inventor02/low-cost-mmwave/pcbs/Dual HF AWR2243 Radar Cascade Board/Photos.pdf

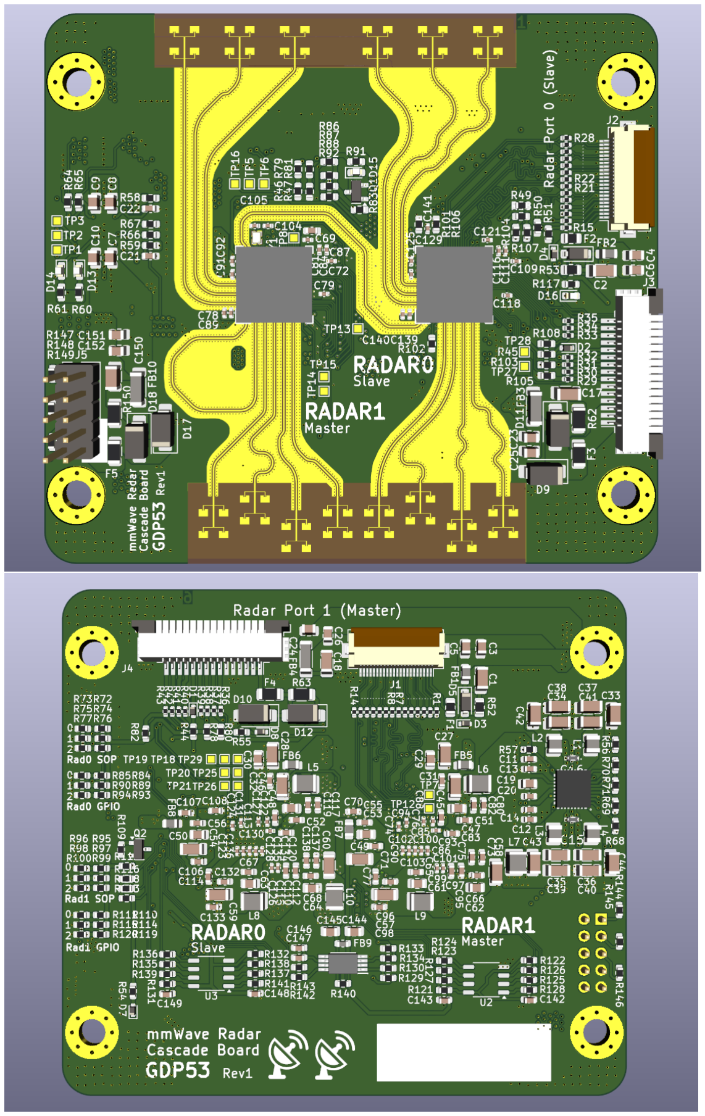
[picture p8: figure]

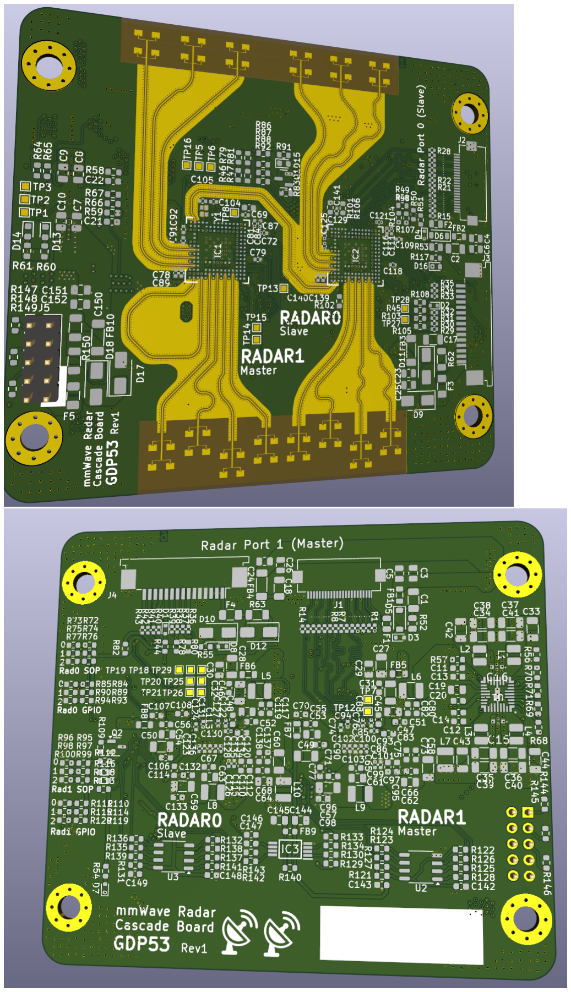
[picture p9: figure]
