inventor02/low-cost-mmwave/code/web-interface/images/range doppler map.png

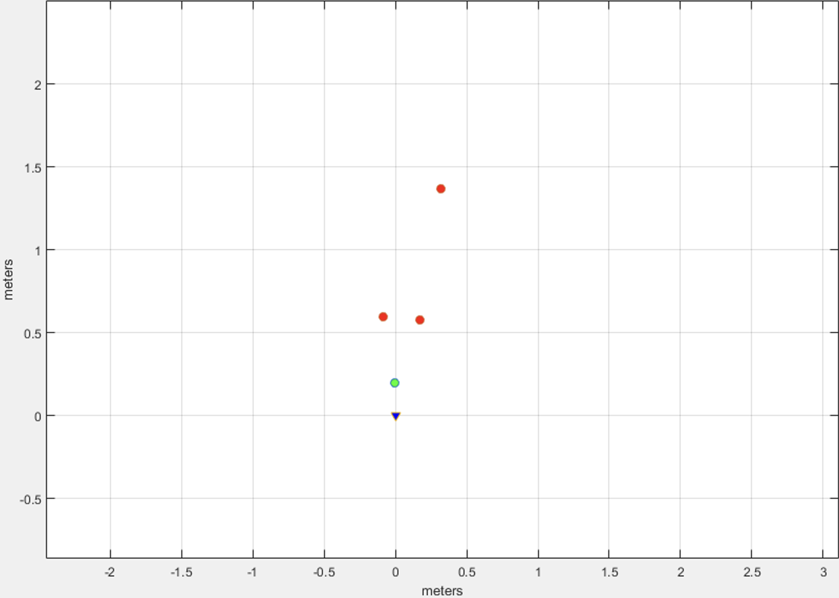
code/web-interface/images/range doppler map.png
