inventor02/low-cost-mmwave/code/web-interface/images/range range map.png

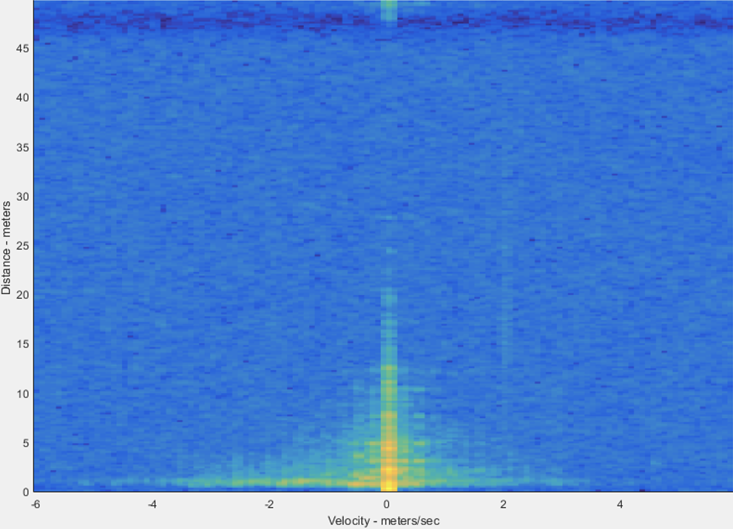
code/web-interface/images/range range map.png
