inventor02/low-cost-mmwave/pcbs/CM4RadarBoard/Board Images/Antenna.jpg

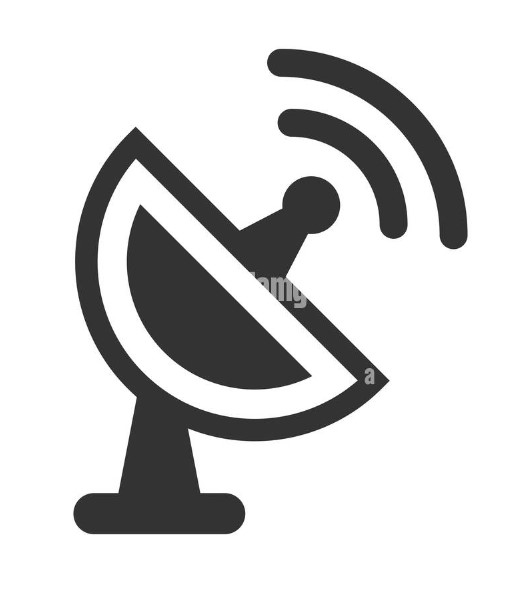
pcbs/CM4RadarBoard/Board Images/Antenna.jpg
