inventor02/low-cost-mmwave/cad/TopPlate.dxf

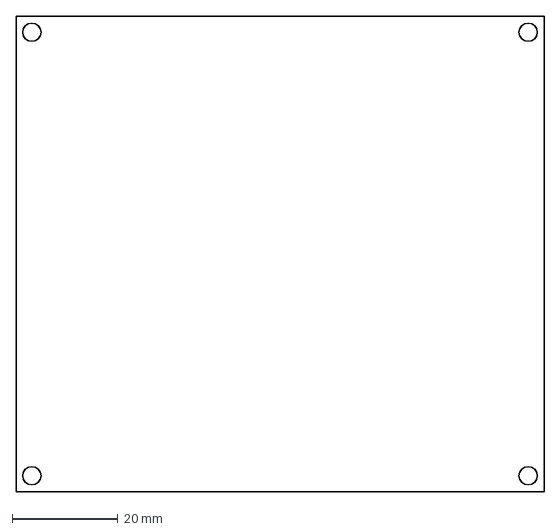
[picture p13: CAD file, 2025-01-19]
cad/TopPlate.dxf
100.0 x 90.0 mm
