inventor02/low-cost-mmwave/pcbs/AdapterBoard/3DModels/QTH-030-01-X-D-A.step

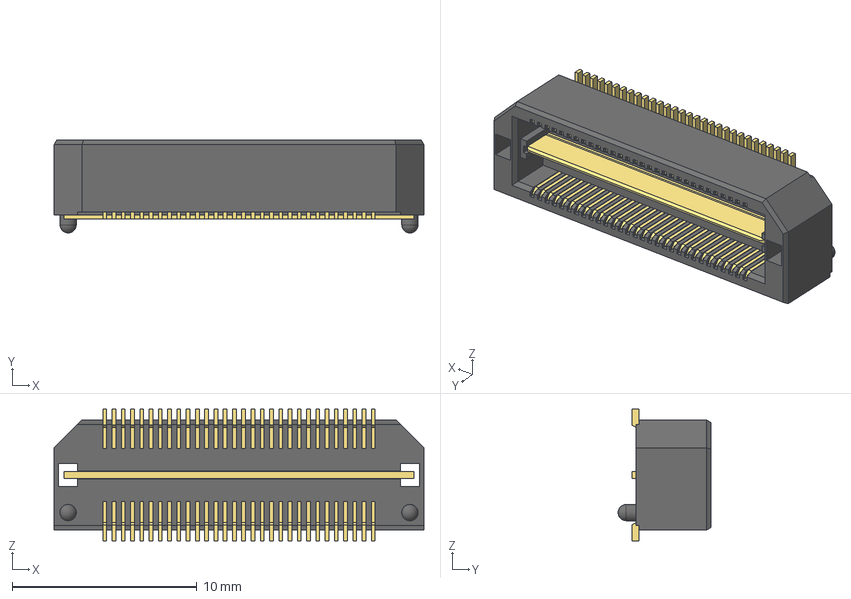
[picture p14: CAD file, 2025-01-20]
pcbs/AdapterBoard/3DModels/QTH-030-01-X-D-A.step
20.0 x 5.03 x 7.11 mm
TQTH-030-01-H-D-A_terminal
T-1S39-01(-030-01-D-H)_pin
T-1S39-01(-030-01-D)_pin2
T-1G1-01_imp
