inventor02/low-cost-mmwave/cad/GDP53_HousingDesignV2.stl

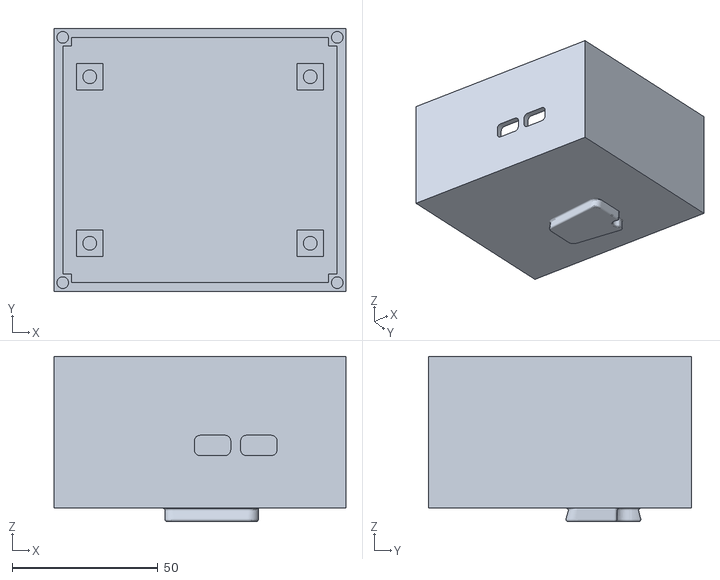
[picture p15: CAD file, 2025-01-19]
cad/GDP53_HousingDesignV2.stl
100.0 x 90.0 x 56.6
