inventor02/low-cost-mmwave/cad/MountPlateCasingGDP53 v1.step

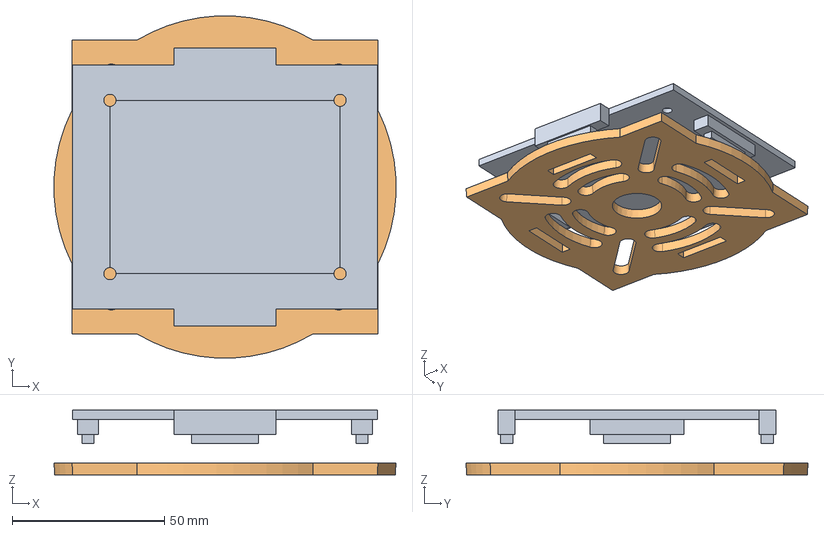
[picture p16: CAD file, 2025-01-19]
cad/MountPlateCasingGDP53 v1.step
112.3 x 112.3 x 21.2 mm
