inventor02/low-cost-mmwave/(list of files, cad)

Other CAD files:
cad/CM4RadarBoardHousingV2 v1.f3d
cad/PowManageBox v1.f3d
cad/PowManageBox v2.2.f3d
cad/PowManageBox v2.f3d
