inventor02/low-cost-mmwave/cad/Housing_Design_Sketch.pdf

# BatteryLipo 3

,

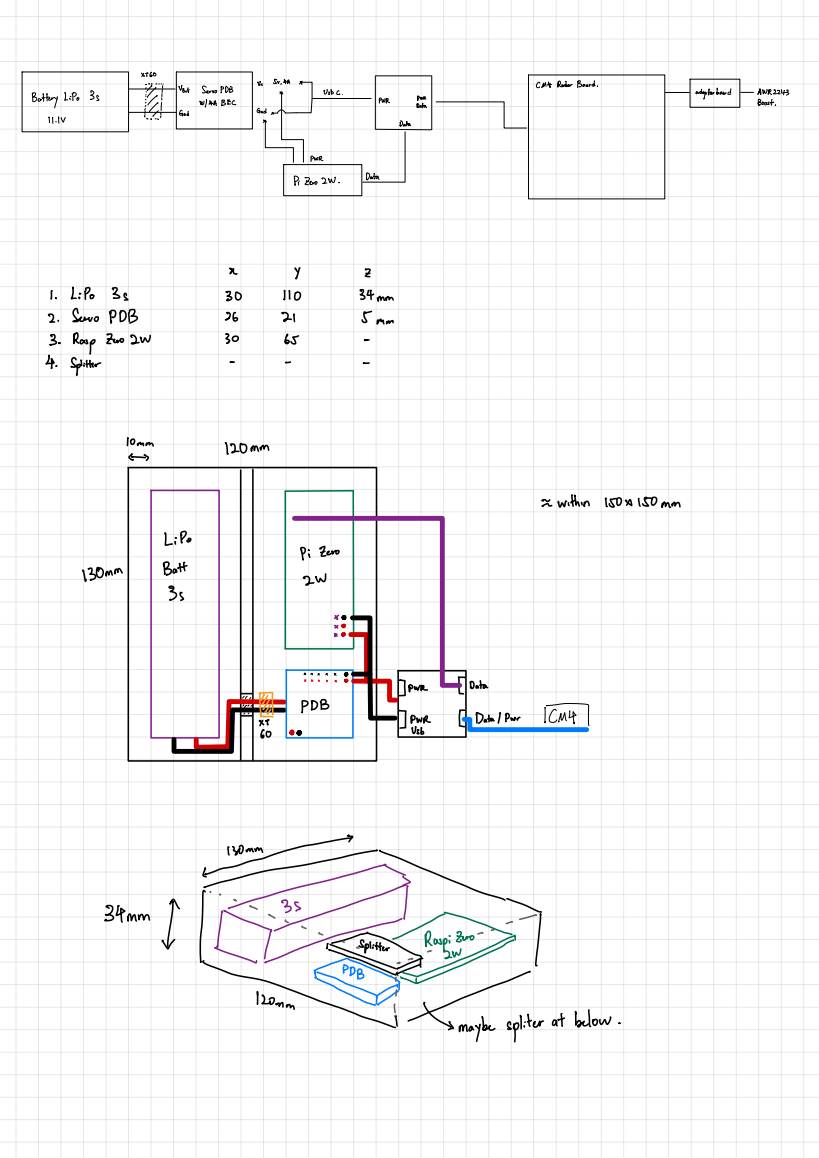
[picture p23: page 1]
UsbC .; adaptarboard; AWR2243; SeoDRB; PWR; Radar Board .; Boost.; Gad; Datta; Pi Zero 2W .; Data; LiPo; Surro; PDB; Rasp; Zero; Splitter; within; Pi Zero; Batt; Jour; [Data; JOUR; [Datalpur; Raspi morZero

2. | 30 Adaptor | board

## Adaptor

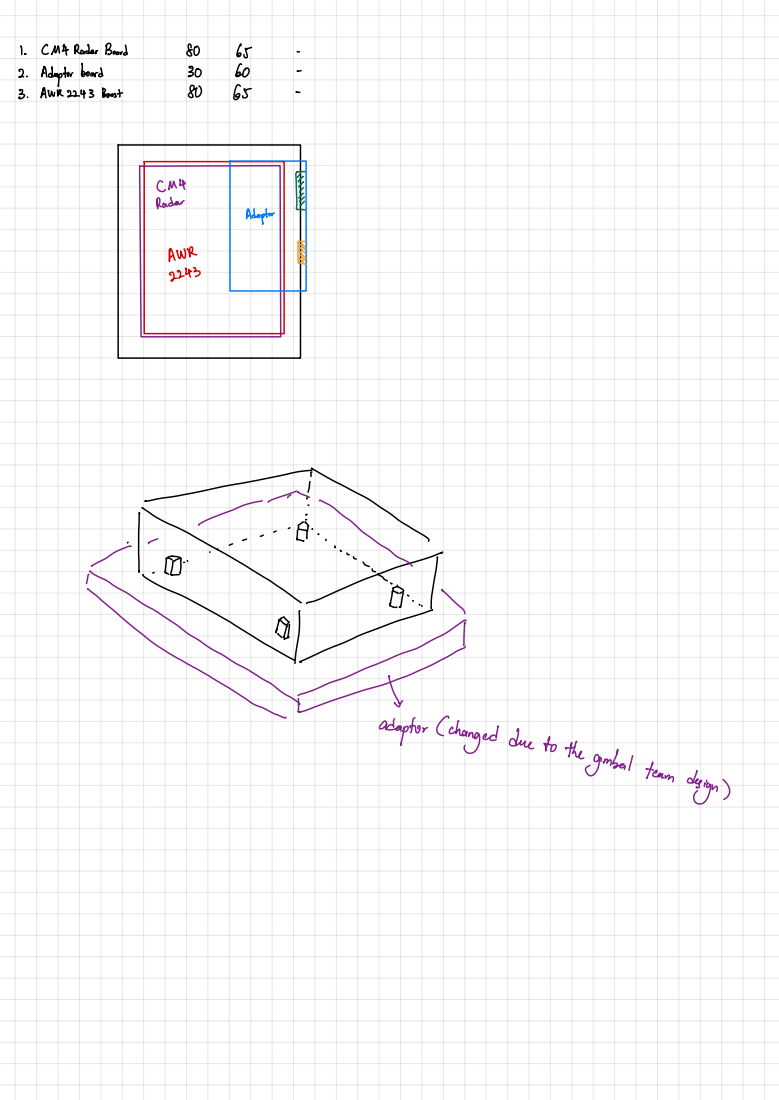
[picture p24: page 2]
CM4 Radar; Board; AWR 2243; Boost; Radar; AWR; adaptor (changed due to thegimbal; team; design
