inventor02/low-cost-mmwave/cad/Housing_Design_Sketch_V2.pdf

# BatteryLipo 3

,

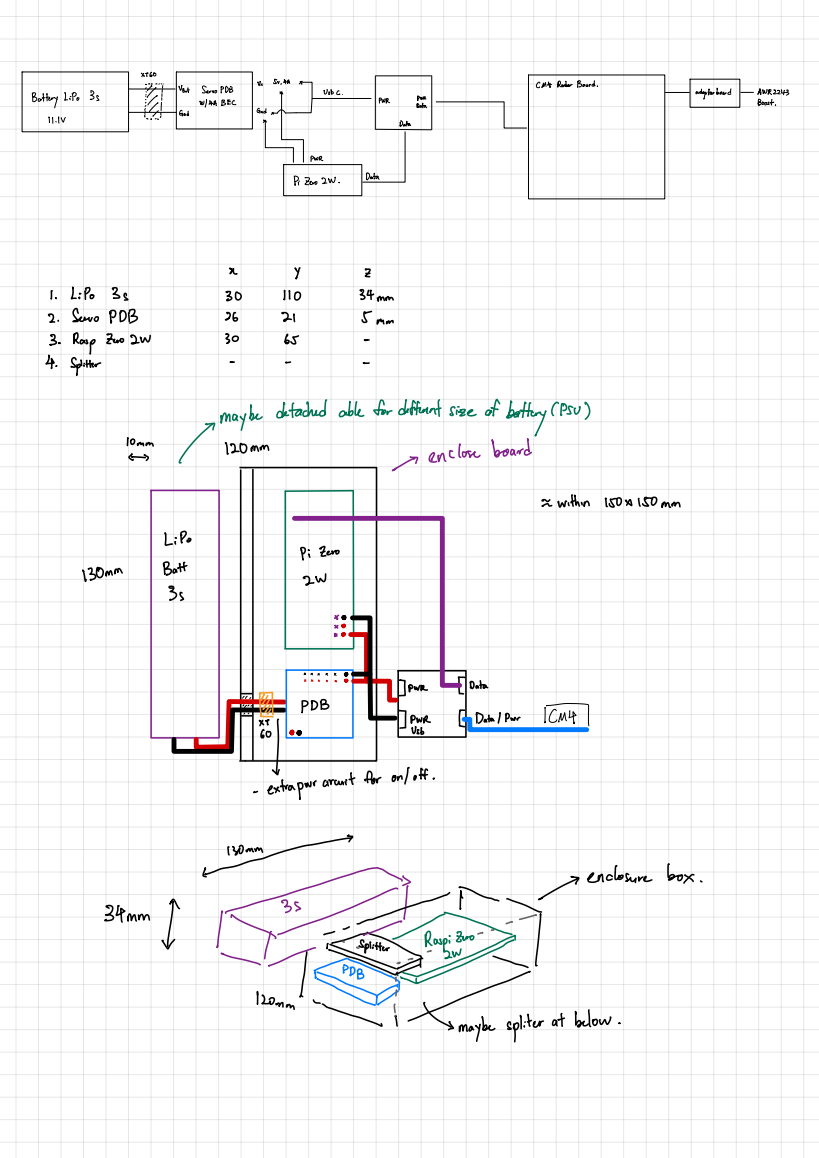
[picture p25: page 1]
SeoDRB; UsbC .; Radar Board .; adaptarboard; AWR2243; PWR; Boost.; Gad; Datta; Pi Zero 2W .; Data; LiPo; Surro; PDB; Rasp; Zero; Splitter; maybe; detached; able for different; size of battery ⁽PSV); comm; enclose; board; piz; Jour; [Data; within; [Datalpur; - TenT

extrapor arcuit for on/off.
Num

Adaptor | board | 30

su

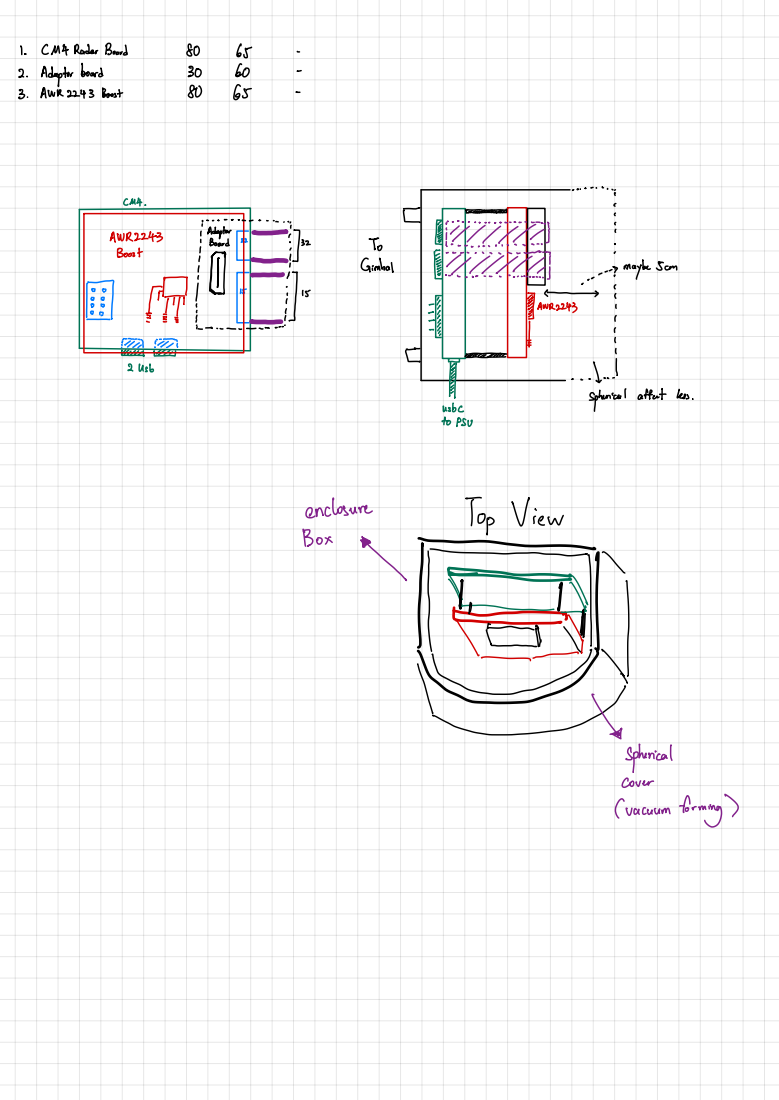
[picture p26: page 2]
CM4 Radar; Board; AWR 2243; Boost; ----- maybe Som; FFantas #11; spherical; affect less.; enclosure; cover; (vacuum; forming⁽

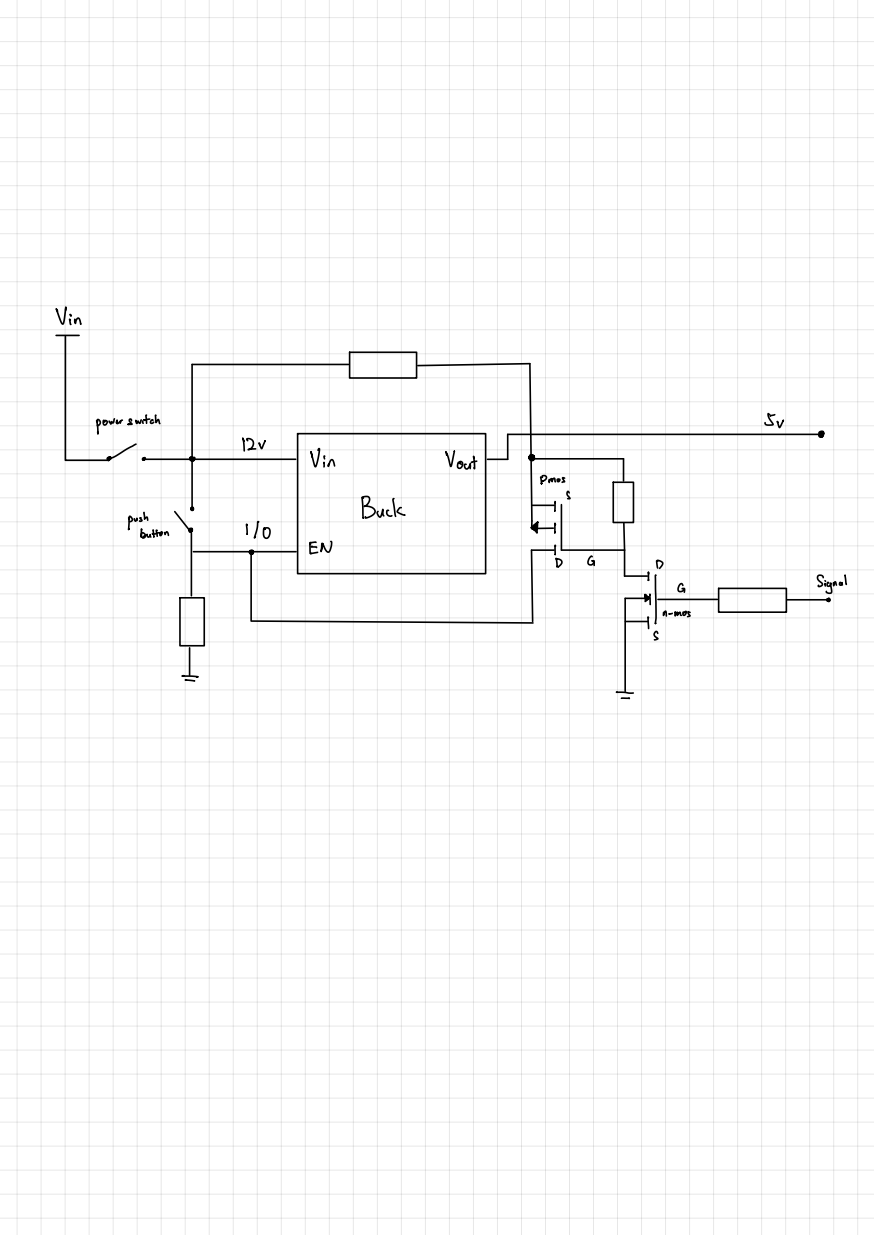
[picture p27: page 3]
Vin; power; switch; Vout; Pmos; Buck; button; push; · Signal n-mos
