inventor02/low-cost-mmwave/pcbs/AdapterBoard/CM4-AWRInterfaceBoard.kicad_pcb

## KiCad design pcbs/AdapterBoard/CM4-AWRInterfaceBoard.kicad_pcb (2025-01-20)

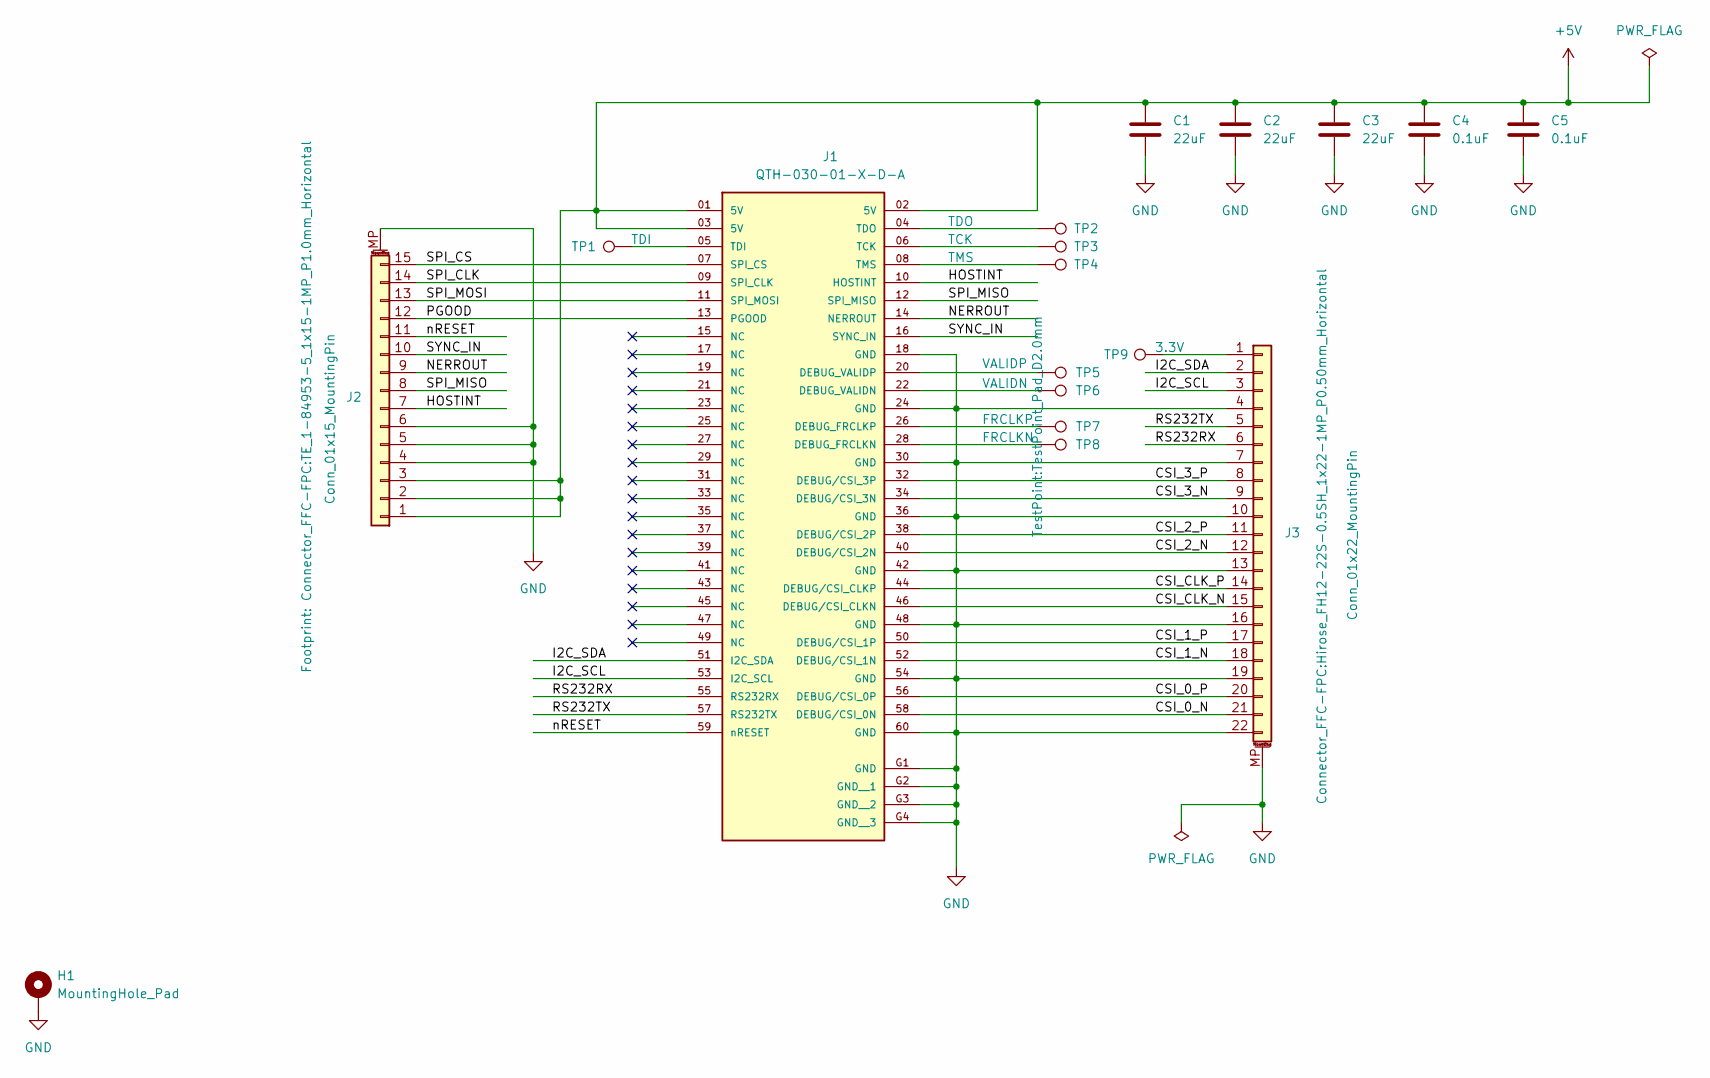
[picture p40: schematic Samtech QTH-030-01-L-D-A.kicad_sch]

Parts:
C1, C2, C3: 22uF; C_1206_3216Metric
C4, C5: 0.1uF; C_0805_2012Metric
H1: MountingHole_Pad; MountingHole_4.3mm_M4_Pad_Via
J1: QTH-030-01-X-D-A; SAMTEC-QTH-030-01-X-D-A; PARTREV L
J2: Conn_01x15_MountingPin; TE_1-84953-5_1x15-1MP_P1.0mm_Horizontal
J3: Conn_01x22_MountingPin; Hirose_FH12-22S-0.5SH_1x22-1MP_P0.50mm_Horizontal
TP1: TDI; TestPoint_Pad_D2.0mm
TP2: TDO; TestPoint_Pad_D2.0mm
TP3: TCK; TestPoint_Pad_D2.0mm
TP4: TMS; TestPoint_Pad_D2.0mm
TP5: VALIDP; TestPoint_Pad_D2.0mm
TP6: VALIDN; TestPoint_Pad_D2.0mm
TP7: FRCLKP; TestPoint_Pad_D2.0mm
TP8: FRCLKN; TestPoint_Pad_D2.0mm
TP9: 3.3V; TestPoint_Pad_D2.0mm

Connections:
+5V: C1.1, C2.1, C3.1, C4.1, C5.1, J1.01 (5V), J1.02 (5V), J1.03 (5V), J2.1, J2.2, J2.3
/Samtech QTH-030-01-L-D-A/CSI_0_N: J1.58 (DEBUG/CSI_0N), J3.21
/Samtech QTH-030-01-L-D-A/CSI_0_P: J1.56 (DEBUG/CSI_0P), J3.20
/Samtech QTH-030-01-L-D-A/CSI_1_N: J1.52 (DEBUG/CSI_1N), J3.18
/Samtech QTH-030-01-L-D-A/CSI_1_P: J1.50 (DEBUG/CSI_1P), J3.17
/Samtech QTH-030-01-L-D-A/CSI_2_N: J1.40 (DEBUG/CSI_2N), J3.12
/Samtech QTH-030-01-L-D-A/CSI_2_P: J1.38 (DEBUG/CSI_2P), J3.11
/Samtech QTH-030-01-L-D-A/CSI_3_N: J1.34 (DEBUG/CSI_3N), J3.9
/Samtech QTH-030-01-L-D-A/CSI_3_P: J1.32 (DEBUG/CSI_3P), J3.8
/Samtech QTH-030-01-L-D-A/CSI_CLK_N: J1.46 (DEBUG/CSI_CLKN), J3.15
/Samtech QTH-030-01-L-D-A/CSI_CLK_P: J1.44 (DEBUG/CSI_CLKP), J3.14
/Samtech QTH-030-01-L-D-A/HOSTINT: J1.10 (HOSTINT), J2.7
/Samtech QTH-030-01-L-D-A/I2C_SCL: J1.53 (I2C_SCL), J3.3
/Samtech QTH-030-01-L-D-A/I2C_SDA: J1.51 (I2C_SDA), J3.2
/Samtech QTH-030-01-L-D-A/NERROUT: J1.14 (NERROUT), J2.9
/Samtech QTH-030-01-L-D-A/PGOOD: J1.13 (PGOOD), J2.12
/Samtech QTH-030-01-L-D-A/RS232RX: J1.55 (RS232RX), J3.6
/Samtech QTH-030-01-L-D-A/RS232TX: J1.57 (RS232TX), J3.5
/Samtech QTH-030-01-L-D-A/SPI_CLK: J1.09 (SPI_CLK), J2.14
/Samtech QTH-030-01-L-D-A/SPI_CS: J1.07 (SPI_CS), J2.15
/Samtech QTH-030-01-L-D-A/SPI_MISO: J1.12 (SPI_MISO), J2.8
/Samtech QTH-030-01-L-D-A/SPI_MOSI: J1.11 (SPI_MOSI), J2.13
/Samtech QTH-030-01-L-D-A/SYNC_IN: J1.16 (SYNC_IN), J2.10
/Samtech QTH-030-01-L-D-A/nRESET: J1.59 (nRESET), J2.11
GND: C1.2, C2.2, C3.2, C4.2, C5.2, H1.1, J1.18 (GND), J1.24 (GND), J1.30 (GND), J1.36 (GND), J1.42 (GND), J1.48 (GND), J1.54 (GND), J1.60 (GND), J1.G1 (GND), J1.G2 (GND__1), J1.G3 (GND__2), J1.G4 (GND__3), J2.4, J2.5, J2.6, J2.MP (MountPin), J3.4, J3.7, J3.10, J3.13, J3.16, J3.19, J3.22, J3.MP (MountPin)
unnamed: J1.28 (DEBUG_FRCLKN), TP8.1
unnamed: J1.26 (DEBUG_FRCLKP), TP7.1
unnamed: J1.22 (DEBUG_VALIDN), TP6.1
unnamed: J1.20 (DEBUG_VALIDP), TP5.1
unnamed: J1.06 (TCK), TP3.1
unnamed: J1.05 (TDI), TP1.1
unnamed: J1.04 (TDO), TP2.1
unnamed: J1.08 (TMS), TP4.1
unnamed: J3.1, TP9.1

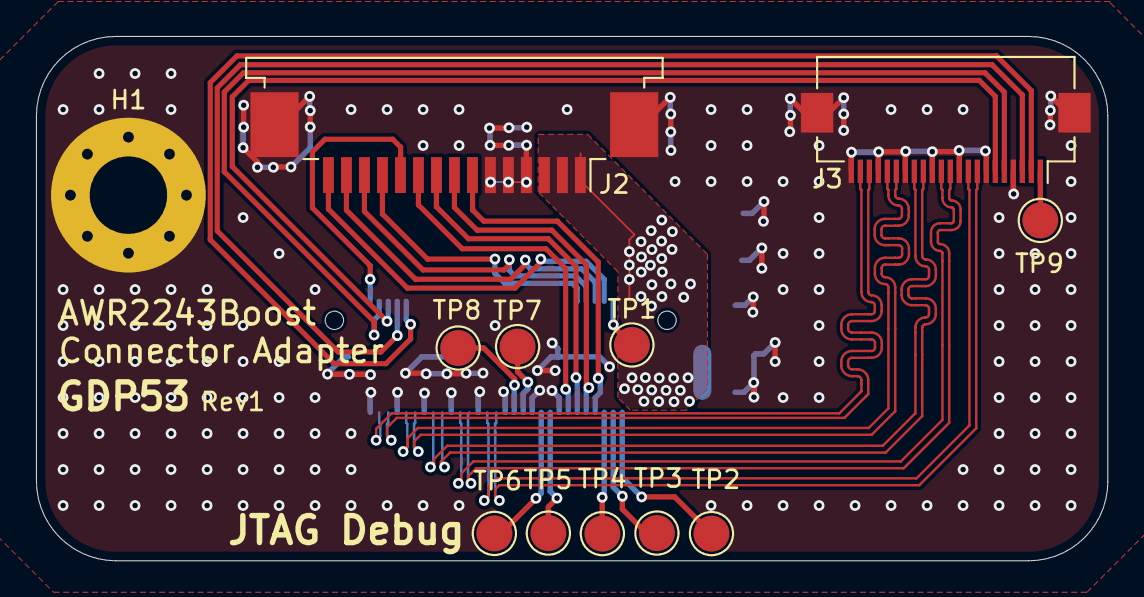
[picture p41: board CM4-AWRInterfaceBoard.kicad_pcb from above]

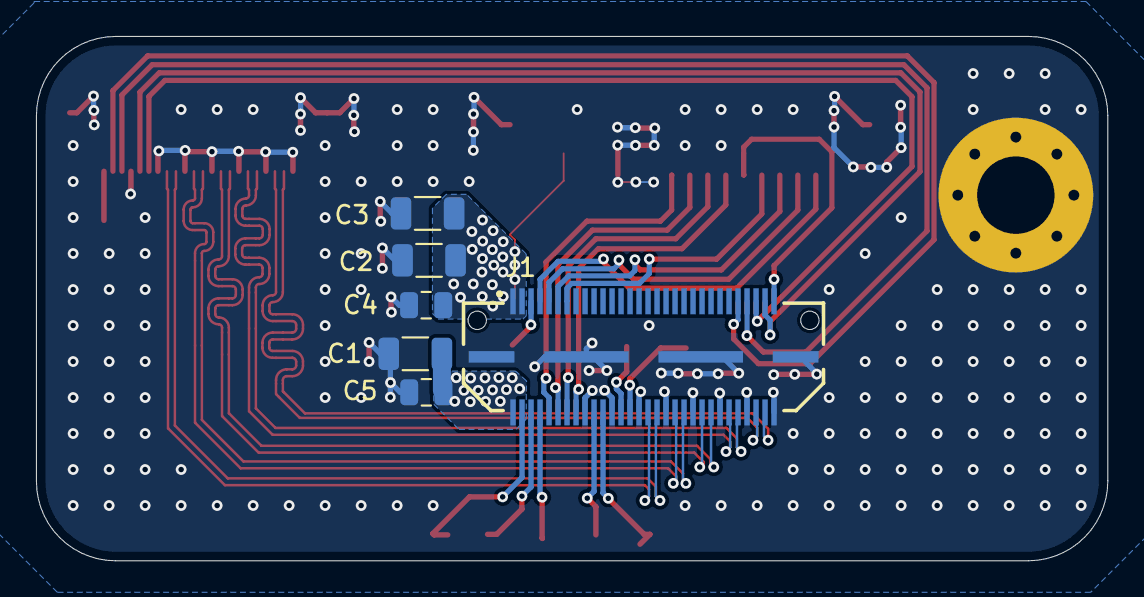
[picture p42: board CM4-AWRInterfaceBoard.kicad_pcb from below]

Board: 2 copper layers, 59.5 x 29.1 mm, 18 parts (6 on the bottom side), 34 nets.
