inventor02/low-cost-mmwave/(commit log)

2025-01-20 add adapter board
    [CM4-AWRInterfaceBoard.kicad_pcb, CM4-AWRInterfaceBoard.kicad_sch, Conn_01x15.kicad_sch, Conn_01x32.kicad_sch, QTH-030-01-X-D-A.step, Samtech QTH-030-01-L-D-A.kicad_sch]
2025-01-20 latest web interface updates
    [imaging_config.txt, mmwaveconfig.txt, overwatch_config.txt]
