inventor02/low-cost-mmwave/(notices)

Notices in the files:
pcbs/AdapterBoard/3DModels/QTH-030-01-X-D-A.step:
author */ ('License CC BY-ND 4.0'),
